ZBagoly19/LK_Bulls/LKBulls2023_Altium/robonaut-altiumtemplate/README.md

# RobonAUT Altium Template

This repository contains a template PCB project for RobonAUT teams. New components and fixes are on the master branch. If you find any bugs or have a suggestion for a standard component, fork from this repo and create a pull request.

On the seminar branch, each milestone of the Altium seminar can be followed and cloned (stage1 - stage9 tags).
