ZBagoly19/LK_Bulls/LKBulls2023_Altium/robonaut-altiumtemplate/BOM/RobonAUT_Project_modified.xlsx

Item # | Supplier | Reference | Name | Quantity
1 | Hestore | 100.224.61 | TACT-64N-F, Nyomógomb, mikrokapcsoló TACT, SPST-NO, THT, 4.3mm, 6x6mm | 1
2 | Hestore | 100.264.66 | TSSM-1022-A2, Kapcsoló, nyelves, 1A/250V AC, M5, SPDT, ON-ON | 1
3 | Hestore | 100.381.18 | DSN-1504-3A, Kapcsolóüzemű step-down feszültségszabályzó, 4.5-28V/0.8-20V, 3A | 3
4 | https://shop.modell.hu/kabel-amass-xt60-cap-apa-csatlakozoval-szerelve | FD-W115M | XT60 + CAP Apa | 1
5 | Lomex | 35-03-94 | FYS-3911BUHR-21 (FYL) 7 SEG SRED COM.AN. 10mm 30mcd 10x13x7mm 640nm | 3
6 | Lomex | 87-01-20 | 74HC595D,118 (NXP) 8-BIT SHIFT-REGISTER WITH OUTPUT LATCH SO-16 | 2
7 | Lomex | 43-26-63 | SZAL.KABEL 6 P APA BH-06 (T-T) | 8
8 | Lomex | 43-03-71 | HÜVELY 40 P FHSH-2.54-40 (T-T) 1# h=8,5mm AU | 1
9 | Lomex | 82-13-46 | 100nF 0805 10% 50V X7R 0805B104K500NT (FNG) | 11
10 | Lomex | 43-09-55 | SORKAPOCS 3 P RM3.81 CPP3.81/3 (STE) LIFTES 1mmř 10A | 3
11 | Lomex | 44-03-11 | 6A 30V 30R600UF POLYFUSE 16.5x16.5mm (LFS) | 1
12 | Lomex | 43-01-11 | SZAL.KABEL 20 P APA 90° BHR-20 (T-T) | 2
13 | Lomex | 86-01-67 | IRFR9024NTRPBF (INF) P-POWERFET 55V 11A 38W Rds<0.175R DPAK | 1
14 | Lomex | 81-10-95 | 4K70 0805 5% CR-05JL7---4K7 0.125W (VIK) | 1
15 | Lomex | 81-34-71 | 100R 0805 5% RC0805JR-10100RL 0.125W (YAG | 1
16 | Lomex | 81-10-87 | 1K00 0805 5% CR-05JL7----1K 0.125W (VIK) | 38
17 | Lomex | 81-10-99 | 10K0 0805 5% CR-05JL7---10K 0.125W (VIK) | 20
18 | Lomex | 81-10-94 | 3K90 0805 5% CR-05JL7---3K9 0.125W (VIK) | 3
19 | Lomex | 81-10-84 | 560R 0805 5% CR-05JL7--560R 0.125W (VIK) | 1
20 | Lomex | 81-11-11 | 100K 0805 5% CR-05JL7--100K 0.125W (VIK) | 1
21 | Lomex | 81-12-65 | 750R 0805 5% CR-05JL7--750R 0.125W (VIK) | 2
22 | Lomex | 43-00-08 | HÜVELY 20 P FHSH-2.54-20 (T-T) 1# h=8,5mm AU | 1
23 | Lomex | 43-00-73 | TÜSKESOR 40 P PHSS-40- 6/3 (T-T) 2.54mm PIN 0.64x0.64 TÖRDELHETÖ | 2
24 | Lomex | 95-00-57 | 2012 GREEN 568nm 70mcd KP-2012MGC (KIN) W.CLEAR 2x1.2x1.1mm 0805 120° | 3
25 | Lomex | 85-00-88 | 16V 0.5W SMSZ1600-35 (MOT) MMSZ5246BT1 SOD-123 ˝J1˝ | 1
26 | Lomex, Hestore | 43-08-97 | TÁPCSATL. 2.54mm 4P APA 180° NCW254-04S (G-S) FORR., HC-05 bluetooth modul 4P, master-slave, gombbal | 2
27 | Mouser | 595-TCA9534PWR | TCA9534PWR 8 Bit I2C I/O Expander | 2
28 | Tanszék | NUCLEO | Nucleo F446RE | 1
29 | Tanszék | Tanszék | STP08CP05TTR, Counter Shift Registers Lo Vltg LoCurent Pwr 8B shift register | 3
+ Extra dolgok:
DS | Lomex | 43-06-67 | HÜVELY 20x2 P FHDH2.54-40 (T-T) 1# h=8,5mm AU | 2
DS | Lomex | 43-00-12 | SZAL.KABEL 6 P ANYA FC-06 (T-T) TEHERMENTESITŐVEL LENGŐ | 8
DS | Lomex | 43-00-57 | SZAL.KABEL 10 P ANYA FC-10 (T-T) TEHERMENTESITŐVEL LENGŐ | 8
DS | Lomex | 43-05-85 | SZAL.KABEL 10 P APA 90° BHR-10 (T-T) | 8
Encoder | Lomex | 43-09-08 | TÁPCSATL. 2.54mm 4P ANYA HÁZ NCH254-04 (G-S) | 2
Bluetooth | Lomex | 43-09-08 | TÁPCSATL. 2.54mm 4P ANYA HÁZ NCH254-04 (G-S) | 2
