ZBagoly19/LK_Bulls/LKBulls2023_Altium/robonaut-altiumtemplate/hallglib.xlsx

Item # | Column=Supplier | Column=Reference | Column=Name | Column=Quantity
1
2
3
