ZBagoly19/LK_Bulls/(list of files, drawings)

Other design files:
Agilent LED Display 7-Segment, 1-Digit/Agilent LED Display 7-Segment, 1-Digit.PcbLib
Agilent LED Display 7-Segment, 1-Digit/Agilent LED Display 7-Segment, 1-Digit.SchLib
kijelzok.SchDoc
LKBulls2023_Altium/robonaut-altiumtemplate/53L0-SATEL-I1.SchDoc
LKBulls2023_Altium/robonaut-altiumtemplate/altium_custom_template.SchDoc
LKBulls2023_Altium/robonaut-altiumtemplate/Bluetooth.SchDoc
LKBulls2023_Altium/robonaut-altiumtemplate/Displays.SchDoc
LKBulls2023_Altium/robonaut-altiumtemplate/DistanceSensors.SchDoc
LKBulls2023_Altium/robonaut-altiumtemplate/Encoder.SchDoc
LKBulls2023_Altium/robonaut-altiumtemplate/IMU.SchDoc
LKBulls2023_Altium/robonaut-altiumtemplate/LineSensors.SchDoc
LKBulls2023_Altium/robonaut-altiumtemplate/LKBulls2022.SchLib
LKBulls2023_Altium/robonaut-altiumtemplate/LKBulls2023.PcbDoc
LKBulls2023_Altium/robonaut-altiumtemplate/LKBulls2023.SchLib
LKBulls2023_Altium/robonaut-altiumtemplate/Manufacturer Part Search/TCA9534PWR/TCA9534PWR/TCA9534PWR.PcbLib
LKBulls2023_Altium/robonaut-altiumtemplate/Manufacturer Part Search/TCA9534PWR/TCA9534PWR/TCA9534PWR.SchLib
LKBulls2023_Altium/robonaut-altiumtemplate/Manufacturer Part Search/TPS562207/TPS562207.PcbLib
LKBulls2023_Altium/robonaut-altiumtemplate/Manufacturer Part Search/TPS562207/TPS562207.SchLib
LKBulls2023_Altium/robonaut-altiumtemplate/MotorControl.SchDoc
LKBulls2023_Altium/robonaut-altiumtemplate/Nucleo.SchDoc
LKBulls2023_Altium/robonaut-altiumtemplate/Power.SchDoc
LKBulls2023_Altium/robonaut-altiumtemplate/RadioCommunication.SchDoc
LKBulls2023_Altium/robonaut-altiumtemplate/RobonAUT_Project.PrjPcb
LKBulls2023_Altium/robonaut-altiumtemplate/Servos.SchDoc
LKBulls2023_Altium/robonaut-altiumtemplate/TopLevel.SchDoc
LKBulls2023_Altium/robonaut-altiumtemplate/VL53L1X-SATEL.SchDoc
main.SchDoc
nucleo_es_egyszerubb_dolgok.SchDoc
RobonAUT_PCB.PcbDoc
RobonAUT_Project.PrjPcb
Sheet1.SchDoc
szervok.SchDoc
tap.SchDoc
TSOP65P640X120-16_sajat.PcbLib
vonalszenzorok.SchDoc
