ZBagoly19/LK_Bulls/(commit log)

2019-09-26 Initial commit - Project template
    [RobonAUT_PCB.PcbDoc, RobonAUT_Project.PrjPcb, hallglib.SchLib, hallglib.xlsx]
2019-09-27 New output job added.
    [RobonAUT_Project.PrjPcb]
2020-09-18 Fixed SLTB004A board footprint.
2021-10-23 Create Sheet1.SchDoc
    Teszt_commitDani
    [Sheet1.SchDoc]
2021-10-23 Update Sheet1.SchDoc
    ujrafrissites
    [Sheet1.SchDoc]
2021-10-23 test commit Zoli
    test commit Zoli
    test sch and proj
    [RobonAUT_Project.PrjPcb, test_Zoli.SchDoc]
2021-10-23 alacool
    alakul
    [RobonAUT_Project.PrjPcb, dcmotor.SchDoc]
2021-10-23 test commits removed
    [RobonAUT_Project.PrjPcb, dcmotor.SchDoc, test_Zoli.SchDoc]
2021-10-23 proba
    proba
    [RobonAUT_Project.PrjPcb, mainsheet.SchDoc]
2021-10-23 Added part to schlib
    IMU
    Shift registerek
    [RobonAUT_Project.PrjPcb, hallglib.SchLib, mainsheet.SchDoc, vonalszenzor.SchDoc]
2021-10-24 Újabb alkatrészek a hallglib-ben
    + encoder
    + távolságszenzor
    Ezek egy-egy kezdetleges schematic-on táppal és capacitator-ral.
    [RobonAUT_Project.PrjPcb, encoder.SchDoc, hallglib.SchLib, mainsheet.SchDoc, tavolsagszenzorok.SchDoc, vonalszenzorok.SchDoc]
2021-10-24 vonalszenzor, motor meghajto
    + vonalszenzor
    + motor meghajto
    schematic-okban apróságok
    [RobonAUT_Project.PrjPcb, hallglib.SchLib, kijelzok.SchDoc, mainsheet.SchDoc, tavolsagszenzorok.SchDoc, vonalszenzorok.SchDoc]
2021-10-25 encoder, 8 segmenses kijelzok
    Javított encoder (nem A1333 kell nekunk, az benne van).
    + 8 segmenses kijelzo
    schematic-okba be
    [RobonAUT_Project.PrjPcb, encoder.SchDoc, hallglib.SchLib, kijelzok.SchDoc, mainsheet.SchDoc]
2021-10-26 kezdetleges kötögetések
    kijelzők összekötése
    máshol apróságok
    [kijelzok.SchDoc, mainsheet.SchDoc, vonalszenzorok.SchDoc]
2021-10-27 második Nucleo
    a Nucleo 2 part-ból áll, ha egymás után tesszük fel, lesz A és B része is
    [mainsheet.SchDoc]
2021-10-29 dc/dc conv-ok, motvez javítás
    + 2 fajta dc/dc
    -+ motvez kimeneteiből a nyák szempontjából szükségtelenek eltávolítva
    [hallglib.SchLib, mainsheet.SchDoc]
2021-10-29 bluetooth
    + buetooth (bár vásárlás után derül ki, melyik lábán mi van pontosan)
    [hallglib.SchLib, mainsheet.SchDoc]
2021-10-30 TIM és UART -ok bekötve
    Nucleo TIM és UART pinjei bekötve, kell még az SPI és az I2C
    [mainsheet.SchDoc, vonalszenzorok.SchDoc]
2021-11-03 TIM1 helyett TIM8, így felszabadultak: I2C3 és USART1
    Motvez TIM1 CH1 és CH2-ről TIM8 CH2 ésCH3-ra. Ezzel felszabadult: I2C3 (távolságszenzornak jó lesz) és USART1 (Thunderboard-é lett). Cserébe CAN-t és hasonló dolgokat vesztünk, ami nem baj)
    [mainsheet.SchDoc, vonalszenzorok.SchDoc]
2021-11-03 táp, motvez felbontása CN-ekre
    táp és ahhoz a védelmek, konverterek külön sch-ra;
    motvez 3 csatlakozóvá alakítva
    [hallglib.SchLib, mainsheet.SchDoc, tap.SchDoc]
2021-11-04 + táp schematic
    [RobonAUT_Project.PrjPcb]
2021-11-04 távolságszenzorok
    vl53l1x-satel
    [hallglib.SchLib, mainsheet.SchDoc, tavolsagszenzorok.SchDoc]
2021-11-05 vonalszenzorok SPI1-e, tápok
    Vonalszenzorok SPI1-en bekötögetve;
    Tápok kicserélgetve jóra;
    Kijelzők engedélyezése felhúzva;
    apró igazgatások
    [kijelzok.SchDoc, mainsheet.SchDoc, vonalszenzorok.SchDoc]
2021-11-07 shiftregister footprint
    shift-register footprintek megcsinalva és hozzáadva
    [hallglib.SchLib]
2021-11-07 Footprint
    3-as stelvio konnektor
2021-11-07 TestCommit
    Laci hülye ezért gyakorol.
    [mainsheet.SchDoc]
2021-11-07 Footprint
    DC-hez a 3as sorkapocs
2021-11-08 tavolsagszenzorok eldobva, apróságok
    [RobonAUT_Project.PrjPcb, mainsheet.SchDoc, tap.SchDoc, tavolsagszenzorok.SchDoc, vonalszenzorok.SchDoc]
2021-11-08 PWM resistor-ok és elnevezések
    [kijelzok.SchDoc, mainsheet.SchDoc, tap.SchDoc, vonalszenzorok.SchDoc]
2021-11-08 apróságok
    [kijelzok.SchDoc, mainsheet.SchDoc]
2021-11-10 kondenzátorok, portok
    kondenzátorok elhelyezve, azt hiszem véglegesen;
    portok main.SchDoc-ba, ez csak el van kezdve
    [RobonAUT_Project.PrjPcb, kijelzok.SchDoc, main.SchDoc, mainsheet.SchDoc, nucleo_es_egyszerubb_dolgok.SchDoc, vonalszenzorok.SchDoc]
2021-11-11 szervók, apróságok
    szervók hallglib-be (de footprint még kell!)
    schematikra, az pedig main.SchDoc-ra;
    portokkal apróságok
    [RobonAUT_Project.PrjPcb, hallglib.SchLib, main.SchDoc, nucleo_es_egyszerubb_dolgok.SchDoc, szervok.SchDoc, tap.SchDoc, vonalszenzorok.SchDoc]
2021-11-12 portok, SPI1, footprint szervóknak
    footprint szervóknak (az eredetiét nem találtuk egyenlőre)
    [hallglib.SchLib, kijelzok.SchDoc, main.SchDoc, nucleo_es_egyszerubb_dolgok.SchDoc, szervok.SchDoc, tap.SchDoc, vonalszenzorok.SchDoc]
2021-11-13 NUCLEO 3V3-on kívül teljesen kész a kapcsolási rajz
    [RobonAUT_Project.PrjPcb, hallglib.SchLib, kijelzok.SchDoc, main.SchDoc, nucleo_es_egyszerubb_dolgok.SchDoc, szervok.SchDoc, tap.SchDoc, vonalszenzorok.SchDoc]
2021-11-13 táp pmos
    pmos bekötve
    [nucleo_es_egyszerubb_dolgok.SchDoc, tap.SchDoc]
2021-11-13 Nucleo_3V3, hidegítések DC/DC-kre
    Elvileg ezzel kész a kapcsolási rajz
    [nucleo_es_egyszerubb_dolgok.SchDoc, tap.SchDoc]
2021-11-14 számozás és resisTOROK
    [RobonAUT_Project.PrjPcb, hallglib.SchLib, kijelzok.SchDoc, main.SchDoc, nucleo_es_egyszerubb_dolgok.SchDoc, szervok.SchDoc, tap.SchDoc, vonalszenzorok.SchDoc]
2021-11-15 Kész 7 szegmens footprint
    Adtam hozzá másik könyvtárat, amiben benne volt a 7 szegmenses, azt módosítottam
    [RobonAUT_Project.PrjPcb]
2021-11-16 footprintek
    sgiftregisterek cserélve
    [RobonAUT_Project.PrjPcb, hallglib.SchLib, kijelzok.SchDoc, vonalszenzorok.SchDoc]
2021-11-16 Domokos kapcsolási rajzzal kapcsolatos észrevételei
    Teams-es kommentek
    [hallglib.SchLib, nucleo_es_egyszerubb_dolgok.SchDoc, tap.SchDoc, vonalszenzorok.SchDoc]
2021-11-17 footprint
    3-as stelvio sorkapocs elkészítve, dc_connectorokhoz hozzáadva
    [hallglib.SchLib, nucleo_es_egyszerubb_dolgok.SchDoc]
2021-11-17 footrpint javitva
    dc connector
    [hallglib.SchLib]
2021-11-17 7 szegmens library, DC cn-ek footprint párosítás
    [RobonAUT_Project.PrjPcb, kijelzok.SchDoc, nucleo_es_egyszerubb_dolgok.SchDoc]
2021-11-17 konnektor elkészítve+led libraby
    [Agilent LED Display 7-Segment, 1-Digit.PcbLib, Agilent LED Display 7-Segment, 1-Digit.SchLib, RobonAUT_Project.PrjPcb]
2021-11-18 Kurrrrva sok footprint dolog
    [hallglib.SchLib, nucleo_es_egyszerubb_dolgok.SchDoc, szervok.SchDoc, tap.SchDoc]
2021-11-19 hibrid dc/dc konverterek
    [hallglib.SchLib, nucleo_es_egyszerubb_dolgok.SchDoc, tap.SchDoc]
2021-11-19 Footrpintek mindenhova
    [hallglib.SchLib, kijelzok.SchDoc, nucleo_es_egyszerubb_dolgok.SchDoc, szervok.SchDoc, tap.SchDoc, vonalszenzorok.SchDoc]
2021-11-19 konzi alatt javítgatott errorok
    [hallglib.SchLib, kijelzok.SchDoc, nucleo_es_egyszerubb_dolgok.SchDoc, szervok.SchDoc, tap.SchDoc, vonalszenzorok.SchDoc]
2021-11-19 szó szerint 1 db karakter
    [RobonAUT_Project.PrjPcb]
2021-11-20 validate project által dobott errorok kijavítása
    port elnevezések egyesítése, lógó lábak passziválása.
    warningból még van pár, lehet soros 1K kell rájuk?
    valamiért nem akar a PcbDoc-ra check-elni egy csomó dolgot, de aztán ráteszi
    [RobonAUT_PCB.PcbDoc, kijelzok.SchDoc, main.SchDoc, nucleo_es_egyszerubb_dolgok.SchDoc, szervok.SchDoc, vonalszenzorok.SchDoc]
2021-11-20 apróságok, gomb
    [nucleo_es_egyszerubb_dolgok.SchDoc, vonalszenzorok.SchDoc]
2021-11-20 javitasok
    gomb, bluetooth hozzáadva
    [hallglib.SchLib, nucleo_es_egyszerubb_dolgok.SchDoc]
2021-11-20 library-k és sch-k egységesítve, PcbDoc-ra felpakolva
    [RobonAUT_PCB.PcbDoc, hallglib.SchLib, kijelzok.SchDoc, nucleo_es_egyszerubb_dolgok.SchDoc, szervok.SchDoc, tap.SchDoc, vonalszenzorok.SchDoc]
2021-11-20 pcb csere
    [RobonAUT_PCB.PcbDoc]
2021-11-21 Footprintek átnézése, kijavítása
    Távolságszenzor nagy változtatása
    [RobonAUT_Project.PrjPcb, hallglib.SchLib, kijelzok.SchDoc, nucleo_es_egyszerubb_dolgok.SchDoc, szervok.SchDoc, tap.SchDoc, vonalszenzorok.SchDoc]
2021-11-21 PCB doksi elkezdve
    [RobonAUT_PCB.PcbDoc]
2021-11-21 maradék dolgok a NYÁK-ra
    [RobonAUT_PCB.PcbDoc, RobonAUT_Project.PrjPcb, nucleo_es_egyszerubb_dolgok.SchDoc]
2021-11-21 vezetékezés kezdés
    [RobonAUT_PCB.PcbDoc]
2021-11-21 kijelzők bekötögetve
    [RobonAUT_PCB.PcbDoc]
2021-11-21 rendezgetés, tömörítés
    [RobonAUT_PCB.PcbDoc]
2021-11-22 bekötögetések kijelzők félig
    [RobonAUT_PCB.PcbDoc, nucleo_es_egyszerubb_dolgok.SchDoc, tap.SchDoc]
2021-11-22 kijelzők készen, gomb készen
    [RobonAUT_PCB.PcbDoc]
2021-11-22 alkatrészek nagyja routolva
    [RobonAUT_PCB.PcbDoc, nucleo_es_egyszerubb_dolgok.SchDoc]
2021-11-22 errorok kijavítása
    [RobonAUT_PCB.PcbDoc, RobonAUT_Project.PrjPcb, kijelzok.SchDoc, nucleo_es_egyszerubb_dolgok.SchDoc, szervok.SchDoc, tap.SchDoc, vonalszenzorok.SchDoc]
2021-11-22 huzalozás majdnem kész
    kell még:
    tápok, GND, vonalnak biztos 5V?, vonal vastagságok (Amper-ek szerint)
    [RobonAUT_PCB.PcbDoc]
2021-11-23 sch files javítva
    [RobonAUT_Project.PrjPcb, hallglib.SchLib, kijelzok.SchDoc, nucleo_es_egyszerubb_dolgok.SchDoc, szervok.SchDoc, tap.SchDoc, vonalszenzorok.SchDoc]
2021-11-23 20k ellenállások javitva
    [kijelzok.SchDoc, nucleo_es_egyszerubb_dolgok.SchDoc, vonalszenzorok.SchDoc]
2021-11-23 pcb drc
    [RobonAUT_PCB.PcbDoc]
2021-11-24 javítások pcb fileban
    [RobonAUT_PCB.PcbDoc, hallglib.SchLib, tap.SchDoc]
2021-11-24 hibajavítások
    rules beállítása mindenhol;
    footprintek javítása
    [RobonAUT_PCB.PcbDoc, tap.SchDoc]
2021-11-25 konzin beszélt dolgok egy része, hibák
    5V vastagság; hibák; csatlakozók, kapcsoló, bluetooth bekötés; vonalszenzorok.SchDoc-ban 5V helyett Nucleo_3V3 az MR-re is
    [RobonAUT_PCB.PcbDoc, vonalszenzorok.SchDoc]
2021-11-25 tápok vastagítása, hibák kijavítása
    [RobonAUT_PCB.PcbDoc]
2021-11-25 gnd-k kiöntve, nyák elkészítve
    11.1 megvastagítva, rules megváltoztatva, hiba nincs
    [RobonAUT_PCB.PcbDoc]
2021-11-25 fésülgetés
    [RobonAUT_PCB.PcbDoc]
2021-11-25 kiöntöttem újra
    [RobonAUT_PCB.PcbDoc]
2021-11-26 új kijelzők
    kijelzőkhöz új shift registerek betéve schematikba és pcbdoc-ba is. a földjeik még nem akarják az igazat
    [RobonAUT_PCB.PcbDoc, kijelzok.SchDoc, tap.SchDoc]
2021-11-26 gnd polygon pourok
    nyák tetején a rádió vevő fölül leszedve a rétegek, hogy ne zavarják;
    új shift registerek gnd lábai belehuzalozva a polygonokba
    [RobonAUT_PCB.PcbDoc]
2021-11-26 polygon pour-ok a tápoknak és lehetőség szerint táp huzalok megvastagítgatása
    [RobonAUT_PCB.PcbDoc]
2021-11-26 gnd polygon pour-ok megigazítva a Teams-es visszajelzés szerint
    [RobonAUT_PCB.PcbDoc]
2021-11-27 új footprint az új shiftregistereknek
    [RobonAUT_PCB.PcbDoc, RobonAUT_Project.PrjPcb, TSOP65P640X120-16_sajat.PcbLib, hallglib.SchLib, kijelzok.SchDoc, nucleo_es_egyszerubb_dolgok.SchDoc, szervok.SchDoc, tap.SchDoc]
2022-09-16 LKBulls2023 branch created and plain schematic sheets added to a new Altium project
    [Displays.SchDoc, DistanceSensors.SchDoc, LKBulls2023.SchLib, LKBulls2023_PCB.PcbDoc, LineSensors.SchDoc, MotorControl.SchDoc, Nucleo.SchDoc, Power.SchDoc]
2022-09-16 Nucleo and STP08 added on schematics
    [Displays.SchDoc, Nucleo.SchDoc]
2022-09-16 LKBulls2022 schematic and pcb library added (copied from other project hallglib pcb and schematic library, and renamed them)
    [LKBulls2022.SchLib]
2022-09-16 Custom RobonAUT Altium Schematic Template created
    [RobonAUT_Project.PrjPcb, altium_custom_template.SchDoc]
2022-09-16 Updated project sheets with the custom Altium template and filled the fields
    [Displays.SchDoc, DistanceSensors.SchDoc, LineSensors.SchDoc, MotorControl.SchDoc, Nucleo.SchDoc, Power.SchDoc, RobonAUT_Project.PrjPcb, Servos.SchDoc]
2022-09-17 Created Encoder and Radio Communication schematic sheets
    [Displays.SchDoc, DistanceSensors.SchDoc, Encoder.SchDoc, LineSensors.SchDoc, MotorControl.SchDoc, Nucleo.SchDoc, Power.SchDoc, RadioCommunication.SchDoc]
2022-09-18 Silabs Thunderboard placed on RadioCommunication.SchDoc sheet
    [RadioCommunication.SchDoc]
2022-09-18 TPS562207 added to SchLib and PcbLib via Manufacturer Part Search
    [LKBulls2023.SchLib, Power.SchDoc, TPS562207.PcbLib, TPS562207.SchLib]
2022-09-18 Power schematic started
    [LKBulls2023.SchLib, Power.SchDoc, RadioCommunication.SchDoc]
2022-09-18 LÉDs added to Power schematic
    [Power.SchDoc]
2022-09-20 Line Sensor Schematic is OK
    [LKBulls2023.SchLib, LineSensors.SchDoc, Nucleo.SchDoc]
2022-09-21 Displays schematic is OK
    [Displays.SchDoc, LKBulls2023.SchLib, Nucleo.SchDoc, Power.SchDoc]
2022-09-21 Fixing a mistake from previous year: STP08 LED Driver R_ext has to be connected to GND and not to VDD
    [Displays.SchDoc]
2022-09-22 RadioCommunication schematic sheet is OK
    [Nucleo.SchDoc, RadioCommunication.SchDoc]
2022-09-22 Minor changes
    [LineSensors.SchDoc, Nucleo.SchDoc]
2022-09-22 Encoder Schematic is OK
    [Encoder.SchDoc, LKBulls2023.SchLib, Nucleo.SchDoc]
2022-09-22 Motor Control schematic is OK
    [LKBulls2023.SchLib, MotorControl.SchDoc, Nucleo.SchDoc]
2022-09-22 Servos schematic is OK
    [Displays.SchDoc, LKBulls2023.SchLib, LineSensors.SchDoc, MotorControl.SchDoc, Nucleo.SchDoc, Power.SchDoc, RobonAUT_Project.PrjPcb, Servos.SchDoc]
2022-09-27 Schematic Sheet for Bluetooth created
    [Bluetooth.SchDoc, Displays.SchDoc, DistanceSensors.SchDoc, Encoder.SchDoc, LineSensors.SchDoc, MotorControl.SchDoc, Nucleo.SchDoc, Power.SchDoc]
2022-09-27 Bluetooth schematic is OK
    [Bluetooth.SchDoc, LKBulls2023.SchLib, Nucleo.SchDoc]
2022-09-27 IMU Schematic created
    [Bluetooth.SchDoc, Displays.SchDoc, DistanceSensors.SchDoc, Encoder.SchDoc, IMU.SchDoc, LineSensors.SchDoc, MotorControl.SchDoc, Nucleo.SchDoc]
2022-09-27 IMU Schematic is OK
    [IMU.SchDoc, LKBulls2023.SchLib, Nucleo.SchDoc]
2022-09-27 Distance Sensors Hierarchical Sheet created with satellite boards as schematic symbols (XSDN pins are not yet connected)
    [53L0-SATEL-I1.SchDoc, DistanceSensors.SchDoc, LKBulls2023.SchLib, Nucleo.SchDoc, RobonAUT_Project.PrjPcb]
2022-09-27 Nucleo schematic updated, checked that everything is used; Servo sensor updated, not used sensor servor deleted; Distance Sensors schematic Notes added
    [DistanceSensors.SchDoc, Nucleo.SchDoc, Servos.SchDoc]
2022-09-27 Sheet Numbering updated
    [53L0-SATEL-I1.SchDoc, Bluetooth.SchDoc, Displays.SchDoc, DistanceSensors.SchDoc, Encoder.SchDoc, IMU.SchDoc, LineSensors.SchDoc, MotorControl.SchDoc]
2022-09-27 Nucleo and Line Sensor schematic SPI lines names are now more expressive
    [LineSensors.SchDoc, Nucleo.SchDoc]
2022-09-29 Distance Sensors schematic updated, XSDN pins connected to Nucleo
    [53L0-SATEL-I1.SchDoc, DistanceSensors.SchDoc, Nucleo.SchDoc]
2022-09-29 Pushbuttons modified/added
    [Nucleo.SchDoc, RobonAUT_Project.PrjPcb]
2022-10-01 Note added about the reserved pins of the Nucleo (Debug, Oscillator pins, etc). Do not attach anything to these pins.
    [Nucleo.SchDoc, RobonAUT_Project.PrjPcb]
2022-10-02 Modifications after a session/meeting together
    [53L0-SATEL-I1.SchDoc, Displays.SchDoc, DistanceSensors.SchDoc, IMU.SchDoc, LineSensors.SchDoc, Nucleo.SchDoc, Power.SchDoc]
2022-10-04 +6V_S1 and +6V_S2 power supply created for the servos
    [Power.SchDoc, Servos.SchDoc]
2022-10-04 VL53L1X schematic symbol created and added to DistanceSensors schematic. VL53L1X (4m range) is fully pin compatible with VL53L0X (2m range)
    [53L0-SATEL-I1.SchDoc, Bluetooth.SchDoc, Displays.SchDoc, DistanceSensors.SchDoc, Encoder.SchDoc, IMU.SchDoc, LKBulls2023.SchLib, LineSensors.SchDoc]
2022-10-04 Based on the VL53L1X datasheet, pull-up resistors added to the I2C bus
    [DistanceSensors.SchDoc]
2022-10-05 TCA9534PWR Schematic Symbol and PCB Footprint added (8 Bit I2C GPIO Expander for the VL53L0X and VL53L1X distance sensors)
    [LKBulls2023.SchLib, TCA9534PWR.PcbLib, TCA9534PWR.SchLib]
2022-10-05 Using two I2C GPIO Expander in order to use multiple VL53L0X and VL53L1X in the system
    [53L0-SATEL-I1.SchDoc, DistanceSensors.SchDoc, LKBulls2023.SchLib, Nucleo.SchDoc, VL53L1X-SATEL.SchDoc]
2022-10-13 Display schematic: STP08CP05TTR LED Driver (here 7 segment driver) VDD changed from 5V to 3.3V based on Domokos Kiss recommendation
    [Displays.SchDoc, IMU.SchDoc]
2022-11-04 LineSensor schematic SPI 1K series resistors relocated to the Nucleo side
    [LineSensors.SchDoc, Nucleo.SchDoc]
2022-11-04 Display schematic 20K pullup replaced by 10K pullup, and STP08CP05TTR VDD changed to +3.3V instead of +5V
    [Displays.SchDoc]
2022-11-04 Power Schematic: +15V Zener diode used at the input, 20K pulldown resistor replaced by 100K, Resistor values for power supply feedback LEDs sized properly
    [LKBulls2023.SchLib, Power.SchDoc]
2022-11-04 Servos schematic: 1K series resistors replaced to Nucleo schematic
    [Nucleo.SchDoc, Servos.SchDoc]
2022-11-04 DistanceSensors schematic: 3 different I2C busses are used, 2 for the 2 different types of sensors, and 1 for the I2C GPIO Expander
    [53L0-SATEL-I1.SchDoc, DistanceSensors.SchDoc, LKBulls2023.SchLib, Nucleo.SchDoc, VL53L1X-SATEL.SchDoc]
2022-11-05 1K Series resistors placed back to the Peripheral sides because Nucleo schematic is too dense
    [DistanceSensors.SchDoc, LineSensors.SchDoc, Nucleo.SchDoc, Servos.SchDoc]
2022-11-05 Notes about 1K series resistors
    [Bluetooth.SchDoc, IMU.SchDoc, RadioCommunication.SchDoc]
2022-11-08 Naming the components on the schematics (annotation)
    [53L0-SATEL-I1.SchDoc, Bluetooth.SchDoc, Displays.SchDoc, DistanceSensors.SchDoc, Encoder.SchDoc, IMU.SchDoc, LineSensors.SchDoc, MotorControl.SchDoc]
2022-11-08 Components Supplier, Reference and Name is OK
    [53L0-SATEL-I1.SchDoc, Bluetooth.SchDoc, Displays.SchDoc, DistanceSensors.SchDoc, Encoder.SchDoc, IMU.SchDoc, LineSensors.SchDoc, MotorControl.SchDoc]
2022-11-13 Changes to review added
    [IMU.SchDoc, RadioCommunication.SchDoc, RobonAUT_Project.PrjPcb]
2022-11-13 Making changes in the schematic based on Domokos Kiss advice
    [53L0-SATEL-I1.SchDoc, Bluetooth.SchDoc, Displays.SchDoc, DistanceSensors.SchDoc, Encoder.SchDoc, IMU.SchDoc, Nucleo.SchDoc, Power.SchDoc]
2022-11-13 Top Level Hierarchical Schematic is OK
    [53L0-SATEL-I1.SchDoc, Bluetooth.SchDoc, Displays.SchDoc, DistanceSensors.SchDoc, Encoder.SchDoc, IMU.SchDoc, LineSensors.SchDoc, MotorControl.SchDoc]
2022-11-13 Line Sensors schematic PCB footprints are OK!
    [LKBulls2023.SchLib, LineSensors.SchDoc]
2022-11-13 Displays Schematic PCB Footprints OK
    [Displays.SchDoc, LKBulls2023.SchLib]
2022-11-13 New PDF generated about the current state of the Schematic
2022-11-13 Power schematic PCB Footprints are OK
    [LKBulls2023.SchLib, Power.SchDoc]
2022-11-13 Servos and MotorControl schematics PCB Footprints are OK
    [MotorControl.SchDoc, Servos.SchDoc]
2022-11-13 Distance Sensors, VL53L1X and VL53L0X schematics PCB Footprints are OK
    [53L0-SATEL-I1.SchDoc, LKBulls2023.SchLib, VL53L1X-SATEL.SchDoc]
2022-11-13 Radiocommunication, Bluetooth and IMU schematics PCB footprints are OK (hopefully all the PCB footprints are OK on all schematics)
    [Bluetooth.SchDoc, IMU.SchDoc, LKBulls2023.SchLib]
2022-11-13 Warnings/Errors checked on the schematics and fixed them (Validate PCB Project)
    [53L0-SATEL-I1.SchDoc, DistanceSensors.SchDoc, LineSensors.SchDoc, Nucleo.SchDoc, RobonAUT_Project.PrjPcb]
2022-11-13 Final touches on the schematics + generating new PDF of the current state of the schematic
    [Bluetooth.SchDoc, Displays.SchDoc, DistanceSensors.SchDoc, LKBulls2023.SchLib, LineSensors.SchDoc, Nucleo.SchDoc, RobonAUT_Project.PrjPcb, Servos.SchDoc]
2022-11-17 Safety backup commit
    [RobonAUT_Project.PrjPcb]
2022-11-17 PcbDoc from last year copied and renamed (so that the design rule settings remain the exact same as they were in last year)
    [LKBulls2023.PcbDoc, LKBulls2023_PCB.PcbDoc, RobonAUT_Project.PrjPcb]
2022-11-17 PCB updated with the components from the schematic
    [LKBulls2023.PcbDoc]
2022-11-17 Board size changed from 145mm*127.5mm to 145mm*150mm
    [LKBulls2023.PcbDoc]
2022-11-17 Keepout layer and board outline layer on Mechanical1 layer added
    [LKBulls2023.PcbDoc]
2022-11-17 Room and Class generation turned OFF
    [LKBulls2023.PcbDoc, RobonAUT_Project.PrjPcb]
2022-11-17 Power schematic placement is OK
    [LKBulls2023.PcbDoc]
2022-11-17 RadioCommunication and Bluetooth Placement is OK
    [LKBulls2023.PcbDoc]
2022-11-17 Display placement OK
    [LKBulls2023.PcbDoc]
2022-11-17 Distance Sensors Front are OK
    [LKBulls2023.PcbDoc]
2022-11-18 Encoder, Motor Control and Distance Sensors rear PCB Layout PLacement is OK
    [LKBulls2023.PcbDoc]
2022-11-18 Initial PCB Layout component placement is OK
    [LKBulls2023.PcbDoc]
2022-11-18 +11.1V is routed
    [LKBulls2023.PcbDoc]
2022-11-18 +5V is OK
    [LKBulls2023.PcbDoc]
2022-11-18 PCB Layout Routing: +3.3V is OK
    [LKBulls2023.PcbDoc]
2022-11-18 PCB Routing: Line Sensor in progress
    [LKBulls2023.PcbDoc]
2022-11-18 PCB Layout Routing: Line Sensor is OK
    [LKBulls2023.PcbDoc]
2022-11-19 PCB Layout Routing Line Sensor small fix
    [LKBulls2023.PcbDoc]
2022-11-19 PCB Layout Routing: Power schematic is OK
    [LKBulls2023.PcbDoc]
2022-11-19 PCB Layout Routing: Servos schematic is OK
    [LKBulls2023.PcbDoc]
2022-11-20 PCB Layout Routing: Displays are OK
    [LKBulls2023.PcbDoc]
2022-11-20 PCB Layout Routing: VL53L1X Sensors are OK
    [LKBulls2023.PcbDoc]
2022-11-20 PCB Layout Routing: VL53L0-SATEL and DistanceSensors Schematic is OK
    [LKBulls2023.PcbDoc]
2022-11-20 PCB Layout Routing: Encoder and MotorControl Schematics are OK
    [LKBulls2023.PcbDoc]
2022-11-20 PCB Layout Routing: IMU is OK
    [LKBulls2023.PcbDoc]
2022-11-20 PCB Layout Routing: Silabs RadioCommunication and Bluetooth is OK
    [LKBulls2023.PcbDoc]
2022-11-20 PCB Layout: Silkscreen nicely adjusted
    [LKBulls2023.PcbDoc]
2022-11-25 PCB Layout: Copper to Copper (so Polygon Pour to everything else) Clearance is set to 10mil (from the old 20mil value).
    [LKBulls2023.PcbDoc]
2022-11-25 GND Polygon Pour created both on Top and Bottom side. Some GND pins are still unconnected.
    [LKBulls2023.PcbDoc, RobonAUT_Project.PrjPcb]
2022-11-25 PCB Layout: Vias nicely added so that all the GND pins and planes/polygon pours are connected everywhere7
    [LKBulls2023.PcbDoc]
2022-11-26 PCB Layout: Minor changes in the design rules related to vias
    [LKBulls2023.PcbDoc]
2022-11-26 PCB Layout: Silkscreen minor changes
    [LKBulls2023.PcbDoc]
2022-11-26 PCB Layout: DRC says everything is OK
    [LKBulls2023.PcbDoc, RobonAUT_Project.PrjPcb]
2022-11-26 .gitignore changed so that Gerber files are also version controlled. PDF, Gerber files and BOM generated.
    [RobonAUT_Project_modified.xlsx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]
2022-11-26 Extra stuff/components added to the BOM manually
    [RobonAUT_Project_modified.xlsx]
2022-11-26 Gerbers ZIP file created for JLC PCB
    [RobonAUT_Project_modified.xlsx]
